bernd2704-cpu/bTn_Wecker_Projekt/Hardware/Stückliste/Cuckoo Clock/LC901_B_beschriftet.png

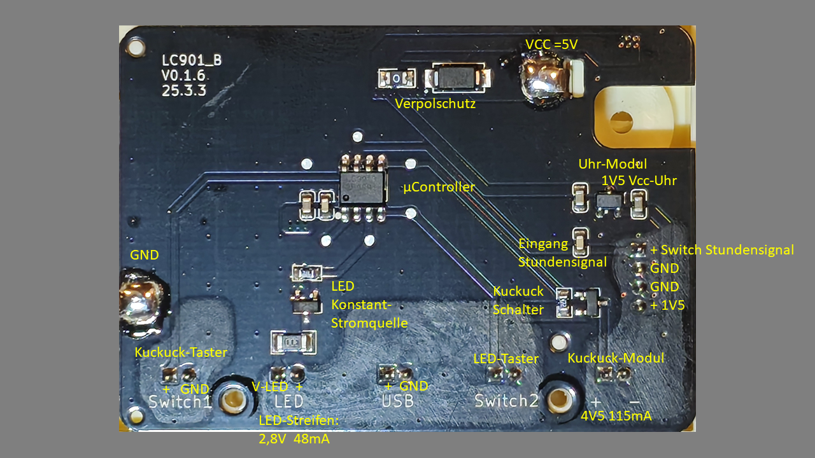
Hardware/Stückliste/Cuckoo Clock/LC901_B_beschriftet.png
