bernd2704-cpu/bTn_Wecker_Projekt/Hardware/Schaltplan/README.md

# Schaltplan

Schaltplan-Dateien hier ablegen (z.B. KiCad, Eagle, PDF).
