bernd2704-cpu/bTn_Wecker_Projekt/Software/Bibliotheken/README.md

# Bibliotheken

Hinweis: Bibliotheken über den Arduino Library Manager installieren.
Siehe README.md im Root für Versionsangaben.
