bernd2704-cpu/bTn_Wecker_Projekt/Hardware/Fotos/README.md

# Fotos

Fotos des Aufbaus und der Hardware hier ablegen.
