bernd2704-cpu/bTn_Wecker_Projekt/Dokumentation/Diagramme/DOC/bTn_Wecker_StateMachines.pptx

Alarm-State-Machine · alarmTask (Core 0, Pri 2) · Takt: 500 ms

Alarmzeit erreicht (a2 analog a1):
sec==0
min==a1_min
hour==a1_hour
min≠lastA1Min

alle ALARM_POLL_MS: readState()

ALARM_IDLE

kein Alarm aktiv

ALARM_RUNNING

MP3 spielt
Ausgänge aktiv

playerStatus == 0 (MP3 beendet)
alle ALARM_POLL_MS (5 s)

S1

S1: manueller Abbruch

Bedingungen für: IDLE → RUNNING: a1_on=true · sec==0 · min==a1_min · hour==a1_hour · min≠lastA1Min (Minuten-Sperre) - a2 analog a1
RUNNING → IDLE: Nach ALARM_POLL_MS (5 s): playerStatus == 0 (MP3 beendet)
Alarm 1 Vorrang: Alarm 2 nur via else-if geprüft → Alarm 1 hat Vorrang bei gleicher Zeit
playerMutex: schützt playFolder()- und readState()-Aufrufe. vTaskDelay(1ms) liegt außerhalb des Mutex.
playerStatus: == 0 (9v4: war < 1) verhindert Fehlabbruch bei readState()-Timeout (UART-Konflikt mit webLogTask)

## Slide 2

Kuckuck-State-Machine · alarmTask (Core 0, Pri 2) · Takt: 500 ms

min==0 · sec==0 · cuckoo_on · Zeitfenster OK · !alarmThisHour · min≠lastCuckooMin

CUCKOO_IDLE

wartet

CUCKOO_RUNNING

E1 HIGH · Kuckuck aktiv

CUCKOO_DURATION_MS (7,5 s) abgelaufen → E1 LOW · lastCuckooMin=0xFF

S1 (kein Alarm aktiv): manuell auslösen · unabhängig von Zeitfenster & cuckoo_on

S1

Zeitfenster-Prüfung: cuckoo_onTime ≤ hour ≤ cuckoo_offTime (normal).
Bei Mitternacht-Überlauf (z.B. 22–06): hour ≥ onTime ODER hour ≤ offTime.
alarmThisHour: (a1_on && a1_min==0 && hour==a1_hour) || (a2_on && a2_min==0 && hour==a2_hour) → Kuckuck unterdrückt.
Minuten-Sperre: lastCuckooMin wird auf t_min gesetzt und erst nach CUCKOO_RUNNING → IDLE auf 0xFF zurückgesetzt.

## Slide 3

Touch-State-Machine · touchTask (Core 0, Pri 2) · Takt: TOUCH_POLL_MS

alle TOUCH_REPEAT_MS (250 ms) → EVT

TS_IDLE

kein Touch aktiv

Touch ON + sofort EVT_TX

TS_PRESSED

Hold-Erkennung läuft

≥ TOUCH_HOLD_MS (750 ms) + EVT

TS_REPEAT

Repeat aktiv

Touch OFF (vor HOLD)

Touch OFF → TS_IDLE

Schwellwert: padWert < (baseline − TOUCH_DROP) → Touch erkannt.
Fallback, wenn baseline < TOUCH_DROP: 80% der Baseline.
Exklusivität: Sobald ein Pad aktiv ist (TS_PRESSED/TS_REPEAT) werden alle anderen Pads ignoriert.
Baseline-Rekalibrierung alle 10 min im TS_IDLE.
ISR Debouncing - Stufe 1: Flanken < BTN_DEBOUNCE_MS (30 ms) werden in der ISR verworfen → saubere Queue.
- Stufe 2: (inputTask): BTN_LOCKOUT_MS (1000 ms) Aktionssperre.

## Slide 4

UI-State-Machine · inputTask (Core 1, Pri 2) + displayTask (Core 1, Pri 1)

UI_CLOCK

Seite 0

UI_ALARM1

Seite 1

UI_ALARM2

Seite 2

UI_SOUND1

Seite 3

UI_SOUND2

Seite 4

UI_FUNCS

Seite 5

UI_CUCKOO

Seite 6

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
Auto-Rückkehr nach AUTO_RETURN_MS (20 s) ohne Touch → UI_CLOCK
Display-Timeout: OLED schaltet nach DISPLAY_TIMEOUT_MS (5 min) ohne Touch ab;
jeder Touch weckt das Display, das auslösende Event wird verworfen

S3

S3

S3

S3

S3

S3

S3

S3 (von jeder Seite) ──▶ UI_INFO

UI_INFO

Info-Seite

AUTO
RETURN

T0

T0 → WiFi-Konfigurator
(clearWifiCredentials + restart)

T4

T4 → Werksreset
(nvs_flash_erase + restart)

T2/T3/T4 State-spezifisch: onClock (Vol±) · onAlarm1/2 (h/min) · onSound1/2 (Datei/Vorschau) · onFuncs (Kuckuck/Licht/Mühlrad) · onCuckooTime (von/bis) · onInfo (WiFi/Reset)
