bernd2704-cpu/bTn_Wecker_Projekt/Hardware/Stückliste/Stückliste.md

# Stückliste – bTn Wecker Projekt

## 1. Mechanik

| Bauteil | Hersteller | Artikel | Lieferant | Preis |
| --- | --- | --- | --- | ---: |
| Cuckoo Clock | ROKR | LC901C | Amazon | 59,45 € |
| Getriebemotor 6mm 3V | Garosa | B085NG5ZCY 4-fach | Amazon | 9,89 € |

## 2. Elektronik

| Bauteil | Hersteller | Artikel | Lieferant | Preis |
| --- | --- | --- | --- | ---: |
| Netzteil | Anker | 323 Charger (33W) | Amazon | 11,99 € |
| ESP32 DEV Kit C V4 | AZ-Delivery | ESP32WROOM32 | AZ-Delivery | 10,99 € |
| OLED 0,96" | APKLVSR | SSD1306OLED | Amazon | 3,54 € |
| DFPlayer Mini | DFRobot | DFR0299 | AZ-Delivery | 2,10 € |
| Micro SD-Card 32GB | Lexar | LMSESXX032G-B2AEU | Amazon | 14,00 € |
| Lautsprecher | Visatone | FRWS 4 ND Breitband 8 Ohm | Voelkner | 16,89 € |
| LDO Spannungsregler 1,5V | Microchip | MCP1700T-1502E/MB | darius GmbH | 2,10 € |
