bernd2704-cpu/bTn_Wecker_Projekt/Hardware/Stückliste/Cuckoo Clock/Ansicht 2.jpg

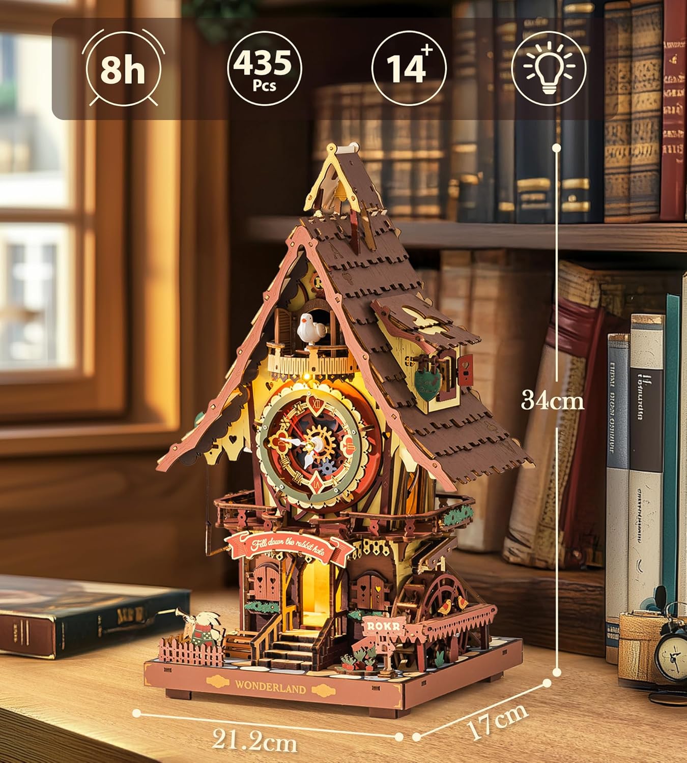
Hardware/Stückliste/Cuckoo Clock/Ansicht 2.jpg
