bernd2704-cpu/bTn_Wecker_Projekt/Hardware/Stückliste/Getriebemotor 6mm 3V/Daten.jpg

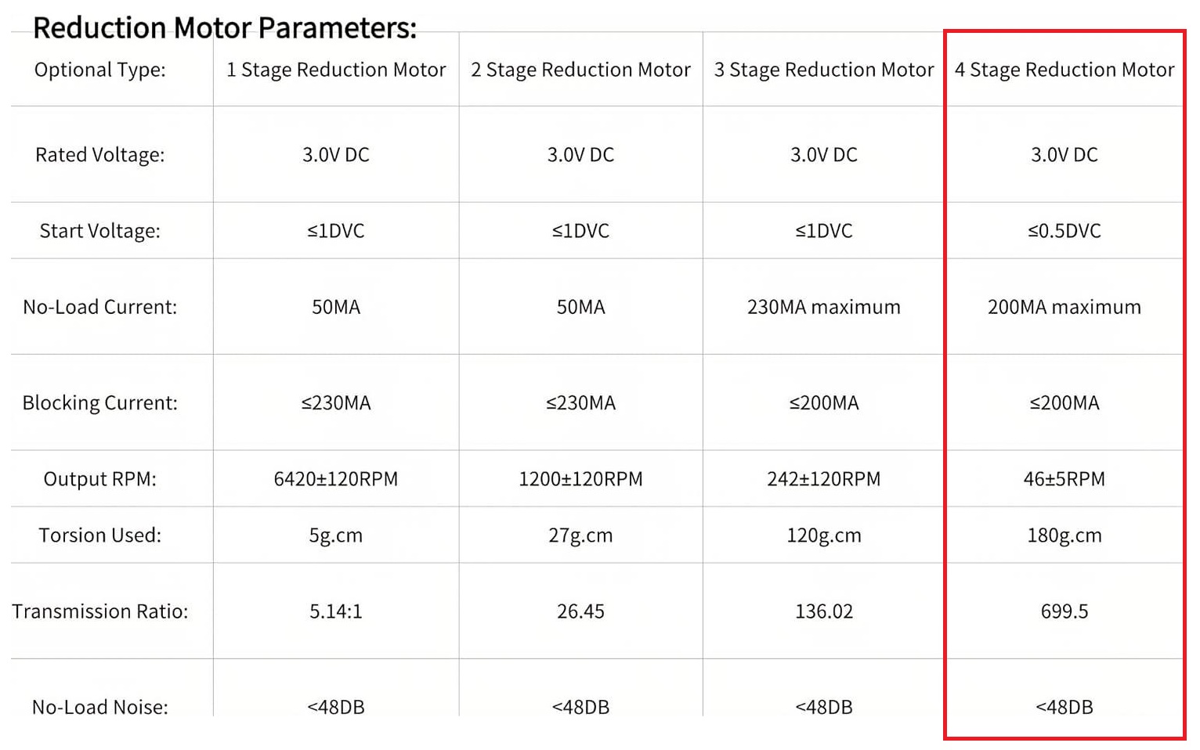
Hardware/Stückliste/Getriebemotor 6mm 3V/Daten.jpg
