bernd2704-cpu/bTn_Wecker_Projekt/Hardware/Stückliste/Lautsprecher/Ansicht 1.jpg

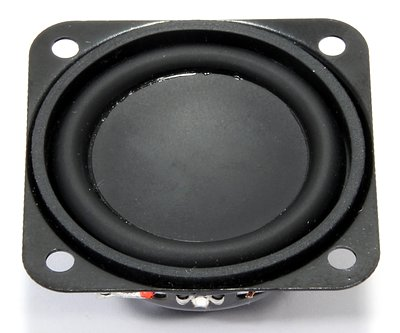
Hardware/Stückliste/Lautsprecher/Ansicht 1.jpg
