bernd2704-cpu/bTn_Wecker_Projekt/(commit log)

2026-04-07 Initial commit – Firmware 9v4, vollständige Projektstruktur
    Enthält: Firmware_aktuell (9v4), Firmware_Versionshistorie (1v1–9v0),
    Dokumentation, Hardware-Platzhalter, CLAUDE.md.
    Bugfix 9v4: playerStatus == 0 statt < 1 verhindert fälschlichen
    Alarm-Abbruch bei UART-Timeout während WebLog-Zugriff.
    [SysConf_9v4.h, WEB.h, Wecker_8v2.ino, Wecker_9v0.ino, Wecker_9v2.ino, Wecker_9v4.ino]
2026-04-07 9v4: Bugfixes aus Code-Review
    - KRITISCH: vTaskDelay() unter playerMutex in inputTask/EVT_S1 behoben
    (Projektregel: Mutex sofort freigeben, vTaskDelay außerhalb)
    - webLogMutex früh in setup() initialisieren: setup()-Meldungen
    (WiFi, NTP) werden jetzt gepuffert statt lautlos verworfen
    - webLogReady-Flag entfernt (toter Code, Mutex war alleiniges Gate)
    - Veraltete Versionsstrings korrigiert:
    WEB.h Footer: 4v0→9v4, Web-Log-Titel: 9v3→9v4, TWDT-Kommentar: 9v3→9v4
    [WEB.h, Wecker_9v4.ino]
2026-04-07 9v5: esp_task_wdt_reconfigure() statt esp_task_wdt_init()
    Behebt "TWDT already initialized"-Fehler: Arduino Core 3.x (IDF 5.x)
    initialisiert den TWDT bereits beim Boot. esp_task_wdt_reconfigure()
    überschreibt die Parameter (Timeout, idle_core_mask, trigger_panic)
    ohne erneute Initialisierung. Dateien auf 9v5 umbenannt.
2026-04-09 9v6: Bugfixes – Web-Log Versionsstring, mp3Count-Clamp, Kommentare korrigiert
    - Web-Log HTML: "9v5" → "9v6"
    - sound1/2_assigned auf mp3Count begrenzt nach DFPlayer-Init
    - Kommentare: alarmTask Core 1→0, playerStatus Core 1→0, BTN_LOCKOUT→DEBOUNCE
    [Wecker_9v6.ino]
2026-04-09 9v6: FW_VERSION-Makro eingeführt – Versionsnummer zentral in SysConf_9v6.h
    PGMInfo, Web-Log-Titel und WEB.h-Footer nutzen jetzt #define FW_VERSION statt
    hart kodierter Strings. PGMInfo nach die Includes verschoben (FW_VERSION muss
    bekannt sein). WEB.h-Raw-String per Split für Makro-Expansion aufgetrennt.
2026-04-09 9v7: Bugfix – EVT_S3 aktualisiert lastTouchMs für korrekte Auto-Rückkehr von UI_INFO
    S3 hat EVT-ID 6, EVT_T4=3. Die Bedingung (evt <= EVT_T4) schloss EVT_S3 aus,
    sodass lastTouchMs beim Öffnen der Info-Seite nicht gesetzt wurde und
    Auto-Return sofort auslöste statt nach 20 s.
    [SysConf_9v6.h, SysConf_9v7.h, Wecker_9v6.ino, Wecker_9v7.ino]
2026-04-10 9v8: Web-Log Auto-Refresh 10 → 20 s
2026-04-10 9v8: Web-Log Reihenfolge – Allg. Log zuerst, dann Touch Baseline, zuletzt Stack HWM
2026-04-10 9v8: Web-Log – Allg. Log-Titel zeigt NTP-Sync-Zeitstempel nach Reset
2026-04-10 9v8: Web-Log – Schriftgröße 13 → 19 px, Zeilen nicht umbrechen (overflow-x:auto)
2026-04-10 9v8: bTn_Alarm_ → bTn_Wecker_ (Kommentar, PGMInfo, WEB.h-Footer)
2026-04-10 9v9: Web-Log – Schriftgröße der Überschriften vergrößert (h2→1.6rem, h3/.sec-title/.snap-title→1rem)
    [SysConf_9v9.h, Wecker_9v9.ino]
2026-04-10 9v10: DFPlayer Start-Sound – readFileCounts() vor playFolder
    Nach Power-On/Flash wurde der Start-Sound abgebrochen, weil der DFPlayer
    seinen SD-Index noch nicht aufgebaut hatte. readFileCounts() dient jetzt
    als Bereitschaftsprüfung: erst wenn der DFPlayer antwortet (SD-Index fertig)
    werden volume/EQ gesetzt und playFolder aufgerufen. Kein UART-Verkehr mehr
    während der Wiedergabe.
2026-04-10 9v11: Stack-Vorgaben reduziert – wifiTask/nvrTask/inputTask/displayTask 2560, watchdogTask 1536
2026-04-10 9v12: Bugfixes aus Code-Review
    (1) Race auf globaler timeinfo/now: timeavailable() nutzt lokale
    tm-Struktur – verhindert torn reads bei SNTP-Callback parallel
    zu showTime() in displayTask
    (2) setup() ohne WiFi-Sync: showTime() vor datum_WiFi/zeit_WiFi-
    Ausgabe, Fallback "--------" statt uninitialisiertem "19000101"
    (3) Dead Code ax_live entfernt (gesetzt, aber nie gelesen)
    (4) Kommentar-Referenz SysConf_9v6.h -> SysConf_9v12.h korrigiert
    [SysConf_9v12.h, Wecker_9v12.ino]
2026-04-10 9v13: Mittlere Issues aus Code-Review behoben
    (1) Race t_start4/lastCuckooMin inputTask vs. alarmTask dokumentiert
    (logisch harmlos, 32-bit atomar auf Xtensa)
    (2) webLogTask "/"-Handler: html.reserve(8192) gegen Heap-Fragmentierung
    durch inkrementelle String-Reallokationen
    (3) Mitternachts-Flackern: One-Shot-Flag midnightDrawn statt ~6-7x
    Full-Redraw in 300-ms-Takt
    (4) sound{1,2}_selected Fallback auf 1 wenn mp3Count == 0
    (verhindert ungueltige DFPlayer-Dateinummer 0 beim Boot)
    (5) Alarm-Start: lastA*Min + State-Uebergang nur NACH erfolgreichem
    playFolder - kein stiller Alarm bei playerMutex-Timeout
    [SysConf_9v13.h, Wecker_9v13.ino]
2026-04-10 9v14: Wartungsqualitaet (Kosmetik aus Code-Review)
    (1) resetCount++ aus readNVR() in bumpResetCount() ausgelagert -
    readNVR() ist jetzt seiteneffektfrei
    (2) t_sec_alt von file-scope in displayTask als static verschoben -
    signalisiert korrekt, dass nur displayTask darauf zugreift
    (3) Task-Handles hStackMonTask + hWebLogTask ergaenzt,
    updateSnapStack() zeigt jetzt auch webLogTask HWM im Web-Log
    [SysConf_9v14.h, Wecker_9v14.ino]
2026-04-11 docs: Versionsangaben auf 9v14 synchronisiert
    CLAUDE.md und README.md nannten noch 9v3 bzw. 8v2 – auf
    aktuellen Stand (Firmware 9v14 / SysConf_9v14.h) gebracht.
2026-04-12 9v14: 7 veraltete/fehlerhafte Kommentare korrigiert
    - menu(6) → menu(7): datum_sync wird auf UI_INFO angezeigt
    - lastTouchMs: EVT_S3 in Kommentar ergaenzt
    - str_reset: max 999 → max 9999 (Format %04lu, Buffer [5])
    - NVR-Abschnitt: "unveraendert" entfernt (bumpResetCount seit 9v14)
    - alarmTask: "verdraengt" → parallele Ausfuehrung (versch. Cores)
    - stackMonTask: "per Serial (4-Byte-Words)" → Web-Snapshot (Bytes)
    - webLogTask: Auto-Refresh "3 s" → "20 s"
    [Wecker_9v14.ino]
2026-04-15 docs: ESP32 Core Version auf 3.3.8 aktualisiert
2026-04-15 9v16: DFPlayer-Kaltstart-Hang behoben via Retry-Schleife
    player.begin() wurde bisher nur einmal aufgerufen. Beim Kaltstart (Power-On)
    ist der DFPlayer noch in eigener Init-Phase und antwortet nicht – begin()
    scheiterte und der DFPlayer blieb stumm. Nach Reset-Taste (VCC bleibt an)
    war der DFPlayer bereits indiziert, daher klappte es dort sofort.
    - player.begin() in Schleife mit DFP_INIT_TIMEOUT_MS (10 s) und
    DFP_INIT_RETRY_MS (500 ms)
    - SETUP_MP3_TIMEOUT_MS 5000 -> 10000 ms (SD-Indizierung nach Power-On
    dauert spuerbar laenger als nach Reset)
    [SysConf_9v16.h, Wecker_9v16.ino]
2026-04-15 fix: Checked-Fillrect um 1px nach rechts/unten verschoben
    [Wecker_9v16.ino]
2026-04-15 fix: Checkbox x-Position -1, Checked-Fillrect auf 4x4
    [Wecker_9v16.ino]
2026-04-15 9v18: Checkboxen 10x10 mit 1px Abstand, Funktion-Seite um 2px nach links
    Checkboxen von 8x8 auf 10x10 vergrößert: 2px Rahmen + 1px Abstand +
    4x4 Check-Füllung. Checkboxen auf Seite Funktion um 2px nach links
    verschoben (x 34 → 32).
2026-04-16 10v05: DFPlayer TX-Pin (GPIO17) 3s LOW vor Serial2.begin() zur Stabilisierung
2026-04-16 10v05: DFPlayer playFolder-delay 1000 → 3000 ms für stabileren Start
2026-04-16 10v05: DFPlayer playFolder-delay 3000 → 4000 ms
2026-04-16 10v06: wakeDisplay() TOCTOU + Race Condition behoben, lastTouchMs volatile
    - BUG 1+3: displayBlanked-Check und lastTouchMs=millis() atomar unter displayMutex
    - BUG 2: lastTouchMs als volatile deklariert (Cross-Core-Sichtbarkeit Core0→Core1)
    [SysConf_10v06.h, Wecker_10v06.ino]
2026-04-17 11v00: Review-Fixes (NVR-Debounce, wifiTask-Guard, Log-Regel)
    Drei Findings aus dem 10v06-Review behoben:
    (1) Flash-Wear: nvrSemaphore erst nach NVR_COMMIT_DELAY_MS (2 s) Ruhezeit
    freigeben; markSafeChange() kapselt safeChange + safeChangeMs-Timestamp.
    (2) wifiTask double-buffer: snprintf nur wenn !wifiSyncPending – schließt
    Torn-Read-Fenster gegen displayTask-memcpy.
    (3) Serial.printf nach WiFi-Connect in setup() durch webLogf ersetzt;
    Log-URL in IP-Zeile konsolidiert.
    [SysConf_11v00.h, Wecker_11v00.ino]
2026-04-17 11v00: Serial.printf mit Log-URL nach WiFi-Connect wiederhergestellt
    Review-Fix (3) aus 11v00 zurückgenommen: die Web-Log-Adresse muss im
    Serial-Monitor sichtbar sein, sonst ist das Web-Log praktisch
    unerreichbar – die URL steht ja erst im Web-Log selbst. Kein Verstoß
    gegen die Projektregel, sondern betrieblich notwendige Ausnahme.
    [SysConf_11v00.h, Wecker_11v00.ino]
2026-04-17 11v00: Dokumentation auf aktuellen Code-Stand gebracht
    - Bedienungsanleitung: Display-Timeout + Display-Wake bei Alarm dokumentiert
    - Changelog: neue Abschnitte 9v15-10v06 und 11v00 ergänzt
    - Funktionsreferenz: Task-Beschreibungen aktualisiert, wakeDisplay()
    und markSafeChange() ergänzt
    - UML-Diagramme entfernt (nicht mehr gepflegt)
2026-04-17 Doku: StateMachines.pptx auf 11v00 (playerStatus == 0)
    Slide 0 (Alarm-FSM): Übergang RUNNING→IDLE aktualisiert –
    'playerStatus < 1' → 'playerStatus == 0' (9v4-Fix).
    Formatierung/Runs erhalten.
2026-04-17 Doku: StateMachines.pptx – Display-Timeout auf Slide 3 ergänzt
    UI-Slide: Annotation um DISPLAY_TIMEOUT_MS-Verhalten erweitert
    (OLED-Abschaltung nach 5 min, Touch-Wake verwirft Event).
    Formatierung des Original-Absatzes übernommen.
2026-04-18 Doku: CLAUDE.md – Version auf 11v00 + externe Libraries ergänzt
    - Aktuelle Version von 10v05 auf 11v00 korrigiert (Repo-Stand).
    - Neuer Abschnitt "Verwendete externe Libraries":
    SSD1306Wire (ThingPulse / Eichhorn, Weinberg) und
    DFRobotDFPlayerMini. Hinweis auf Verwechslungsgefahr mit
    Alexander Pronins gleichnamiger AVR-Library.
2026-04-18 Doku: Formatierungsanpassungen in Bedienungsanleitung.docx und StateMachines.pptx
    Reine Formatierung, keine inhaltlichen Änderungen.
2026-04-18 Doku: Funktionsreferenz als .md-Startbasis + Konvertierungs-Skript
    - bTn_Wecker_Funktionsreferenz.md: aus der .docx extrahierte Markdown-
    Version (7 Kapitel, Tabellen mit <br> in mehrzeiligen Zellen).
    Dient als Source of Truth für zukünftige Änderungen.
    - _docx_to_md.py: einmaliges Helferskript für docx→md-Extraktion
    (Python, stdlib-only). Bleibt im Repo, um auch Bedienungsanleitung
    und Changelog bei Bedarf konvertieren zu können.
2026-04-20 Doku: Funktionsreferenz – bTn_info() in Systemfunktionen ergänzt
2026-04-20 Doku: Funktionsreferenz – runAlarmMachine() Abbruchbedingung auf playerStatus==0 korrigiert (9v4-Stand)
2026-04-20 Doku: Funktionsreferenz – drei veraltete/ungenaue Einträge korrigiert
    - webLogTask: NTP-Sync ist kein Snapshot-Block, nur Titelzeile im Allg. Log (9v8)
    - alarmTask: wakeDisplay()-Aufruf bei Alarmstart ergänzt (10v03)
    - isrS1/S2/S3: Entprell-Check als millis()-isrBtnMs[0] ≥ BTN_DEBOUNCE_MS präzisiert
2026-04-20 Doku: Funktionsreferenz – Stack-Größen bei allen 9 Tasks konsistent gelistet
    touchTask 3072, alarmTask 2048, stackMonTask 3072, webLogTask 4096
    ergänzt (Werte aus SysConf_11v00.h STACK_*).
2026-04-20 Doku: Mermaid-Version der 4 State-Machine-Diagramme ergänzt
    Markdown-Pendant zu bTn_Wecker_StateMachines.pptx – Git-diff-fähig
    und auf GitHub direkt gerendert (Alarm-, Kuckuck-, Touch-, UI-SM).
2026-04-20 Doku: .docx und .pptx in Dokumentation/Diagramme/DOC/ verschoben
    Analog zu Technisch/DOC/ – Markdown bleibt im Hauptordner,
    generierte Office-Exporte getrennt.
2026-04-20 11v01: Web-Log – neue Rubrik "Status – Letzter Start" (WiFi + NTP)
    Zeigt im Web-Log oberhalb des allgemeinen Logs die beiden Zeilen
    WiFi (datum_WiFi/zeit_WiFi) und NTP (datum_sync/zeit_sync) analog
    zur Info-Seite der OLED-Anzeige.
2026-04-20 11v02: S3 weckt Display (analog T0-T4) – Schutz vor ungewolltem Reset
    - inputTask: bei displayBlanked wird jetzt auch EVT_S3 nur als Wake-Event
    gewertet und verworfen (vorher: evt <= EVT_T4). Verhindert, dass bei
    aktiver UI_INFO ohne Anzeige ein Tasterdruck den Info-Toggle durchreicht
    bzw. ein nachfolgender T0/T4-Touch versehentlich WLAN-Reset oder
    Werksreset auslöst.
    - UI_INFO-Seite zeigt die gefährlichen Aktionen explizit:
    "T0: WLAN RESET SSID PW" und "T4: WERKSRESET" statt duplizierter
    WiFi-/NTP-Zeiten.
    - Web-Log: Rubrik "Status – Letzter Start" umbenannt in
    "Verbindung – letzter WiFi Reconnect / NTP Sync" und unter die
    Ring-Puffer-Sektion verschoben.
    - Dateien umb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
    [SysConf_11v02.h, Wecker_11v02.ino]
2026-04-20 11v02: Info-Seite – Zeile T0 auf "RESET SSID PW" gekürzt
    [SysConf_11v02.h, Wecker_11v02.ino]
2026-04-20 11v03: resetCount zählt Konfigurator-Boot nach Werksreset nicht mehr mit
    bumpResetCount() in setup() wird erst nach loadWifiCredentials() aufgerufen
    und öffnet den NVR-Namespace selbst. Damit zeigt der Zähler nach einem
    Werksreset korrekt 1 statt 2 beim nächsten regulären Boot.
    [SysConf_11v03.h, Wecker_11v03.ino]
2026-04-20 Doku: Funktionsreferenz auf 11v03 – bumpResetCount-Beschreibung ergänzt
2026-04-20 Doku: Bedienungsanleitung als .md erzeugt und auf 11v03 aktualisiert
    Aus .docx via _docx_to_md.py extrahiert. Inhaltliche Nachpflege:
    - Versionsstand 11v00 → 11v03
    - S3: Hinweis zu Display-Wake (11v02)
    - Info-Seite: T0/T4-Warnhinweise, WiFi/NTP-Zeilen entfernt (11v02)
    - Web-Log: Sektion "Verbindung – letzter WiFi Reconnect / NTP Sync" (11v02)
    - Werksreset: Reset-Zähler startet nach Konfigurator-Boot bei 0001 (11v03)
2026-04-20 11v04: S3 bei dunklem Display weckt UND öffnet Info-Seite
    inputTask: Wake-Pfad für EVT_S3 reicht das Event jetzt weiter an uiDispatch()
    statt es zu verwerfen. Touch T0–T4 bleiben Wake+Discard (Reset-Schutz).
    Auto-Return (20 s) garantiert, dass das Display nur von UI_CLOCK aus blanken
    kann, der S3-Toggle landet daher deterministisch auf UI_INFO.
    Doku: Changelog, Funktionsreferenz, Bedienungsanleitung auf 11v04.
    [SysConf_11v04.h, Wecker_11v04.ino]
2026-04-20 Doku: 11v02 nachgepflegt + kleinere Korrekturen auf 11v04-Stand
    - Changelog: fehlender Abschnitt "Version 11v02" ergänzt
    (S3-Wake-Schutz, Info-Seite T0/T4, Web-Log-Rubrik-Umbenennung,
    T0-Zeile gekürzt); Kopfzeile "Basis 4v1 → 11v04".
    - Funktionsreferenz: webLogTask-Sektionsliste um "Verbindung
    – letzter WiFi Reconnect / NTP Sync" ergänzt.
    - Bedienungsanleitung: Kopfzeile-Beispiel auf bTn_Wecker_11v04;
    Allg.-Log-Beschreibung präzisiert (NTP-Zeitstempel des
    letzten Resets).
2026-04-21 11v05: Info-Seite neu – WLAN-Reset auf T3 (Taste +), Werksreset bleibt T4
    - Info-Seite: Z1 Version, Z2 Web-Log-URL, Z3 MP3/Reset, Z4 "Taste + WiFi Reset",
    Z5 " Taste - Full Reset" (einheitliche +/--Bedienung wie auf Kuckuck-Seite).
    - onInfo(): EVT_T0 -> EVT_T3 fuer WLAN-Reset; T4 unveraendert (Werksreset).
    - uiDispatch(): T0-Guard auf UI_INFO bleibt (Out-of-Bounds-Schutz fuer cycle[]),
    T0 auf INFO ist seit 11v05 ohne Funktion.
    - Wake-Discard-Kommentar, State-Machine-Diagramm und Changelog nachgezogen.
    - Rename SysConf_11v04.h -> SysConf_11v05.h, Wecker_11v04.ino -> Wecker_11v05.ino,
    FW_VERSION 11v04 -> 11v05.
    [SysConf_11v05.h, Wecker_11v05.ino]
2026-04-21 Doku: 11v05 nachgepflegt – WLAN-Reset T0 -> T3 auf Info-Seite
    - Bedienungsanleitung: Info-Seiten-Tabelle neu geordnet (Z1..Z5),
    WLAN-Konfig-Abschnitt auf T3 (Taste +), Sicherheitstext/Fussnote 11v05.
    - StateMachines: Transition "T0 -> WiFi-Konfigurator" -> "T3 -> ...";
    Version im Header und Fussnote auf 11v05 gehoben.
    - Changelog: neuer Abschnitt Version 11v05 (drei Eintraege:
    Funktion/UI_INFO Taste-Mapping, Funktion/Layout, Qualitaet/Kommentare);
    Basis-/Stand-Angaben 11v04 -> 11v05.
    - Funktionsreferenz: onInfo-Zeile auf T3 + neues Zeilenlayout,
    Versionsangaben im Header und in der Fusszeile aktualisiert.
    - README.md + CLAUDE.md: aktuelle Firmware 11v05, SysConf_11v05.h.
    Co-Auth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
2026-04-21 11v05: Info-Seite – WiFi/Werks-RESET-Labels rechtsbündig
    [Wecker_11v05.ino]
2026-04-21 Versionshistorie: auf letzte 5 Versionen gekürzt (8v2, 9v0, 9v2, 9v6, 9v17)
    Ältere Versionen werden lokal unabhängig archiviert und müssen nicht
    im Repo mitgeschleppt werden.
2026-04-21 Versionshistorie: Struktur auf Ordner je Version umgestellt (11v00–11v05)
    - Pro Version eigener Unterordner Wecker_<version>/ mit ino, SysConf und WEB.h
    - Inhalt auf 5 neueste Versionen (11v00, 11v01, 11v02, 11v04, 11v05) refresht
    - Alte flache 8v2/9v* Dateien entfernt
2026-04-22 Stückliste: Hardware-BoM als Markdown-Tabellen angelegt
    Mechanik (Cuckoo Clock) und Elektronik (Netzteil, ESP32, OLED,
    DFPlayer Mini, Micro SD-Card, Lautsprecher) mit Hersteller, Artikel,
    Lieferant und Preis. Spaltenbreiten projektweit einheitlich,
    Preis-Spalte rechtsbündig.
2026-04-22 Stückliste: Hersteller/Artikel für ESP32 und DFPlayer ergänzt
    ESP32 DEV Kit C V4: AZ-Delivery / ESP32WROOM32
    DFPlayer Mini: DFRobot / DFR0299
2026-04-22 Stückliste: Getriebemotor 6mm 3V (Garosa, B085NG5ZCY) ergänzt
2026-04-22 Stückliste: LDO Spannungsregler 1,5V (Microchip, MCP1700T-1502E/MB) ergänzt
2026-04-22 Stückliste: README.md je Bauteil entfernt, stattdessen Datenblätter, Bilder und Hersteller-Dokumente in den Bauteil-Ordnern abgelegt
2026-04-23 Firmware 12v00: Motor-Ansteuerung auf PWM (LEDC) umgestellt
    Integration der Hardware-Erweiterung aus
    Hardware/hardware_notesmotor_led_driver.md:
    - E2 (GPIO26, Wasserrad-Motor) jetzt per ledcWrite mit 20 kHz /
    8 Bit / 60 % Duty (=153) – 3-V-Motor läuft an 5-V-Versorgung
    mit passendem Mittelwert und ohne hörbares Schaltgeräusch.
    Neue Konstanten MOTOR_PWM_FREQ/_RES/_DUTY in SysConf_12v00.h.
    Stellen in alarmTask (Alarm 1/2 Start + Ende + S1-Abbruch) und
    S2-Zugschalter auf ledcWrite(E2, MOTOR_PWM_DUTY / 0) umgestellt.
    pinMode(E2,OUTPUT) in setup() durch ledcAttach ersetzt.
    - E3 (GPIO27, LED-Streifen) bleibt digitalWrite(HIGH/LOW) –
    ohmsche Last mit 47 Ω Vorwiderstand, PWM n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
2026-04-26 Hardware: Schaltpläne für Kuckuck-, LED- und Motor-Treiber ergänzt, Gate-Widerstand auf 330Ω angepasst
2026-04-26 Hardware: Motor-Treiber-Schaltplan mit AMS1117-Versorgung und GPIO26 präzisiert
2026-05-16 Firmware 12v01: Stack-Größen neu vorgegeben, Doku-Resync auf 12v01
    - Stack-Größen (Bytes): touchTask 2880, wifiTask 2000, nvrTask 2304,
    inputTask 2240, displayTask 2176, alarmTask 2128, watchdogTask 1344,
    stackMonTask 2912; webLogTask (4096) unverändert
    - Wecker_12v00 -> Wecker_12v01, SysConf_12v00 -> SysConf_12v01 (git mv)
    - Versionsnummern projektweit auf 12v01 (CLAUDE.md, README, .ino-Include)
    - Changelog: nachgezogener 12v00-Block (Motor-PWM) + neuer 12v01-Block
    - Funktionsreferenz: Stack-Werte je Task aktualisiert, Header/Footer 12v01
    - StateMachines/Bedienungsanleitung: Header/Footer auf 12v01
    - Versionshistorie: Wecker_12v00-Snapshot refresh, Wecker_12v01 ergänzt,
    Wecker_1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
